joshua-sct/CatAlarm/hardware/catalarm6.kicad_pcb

## KiCad design hardware/catalarm6.kicad_pcb (2025-02-18)

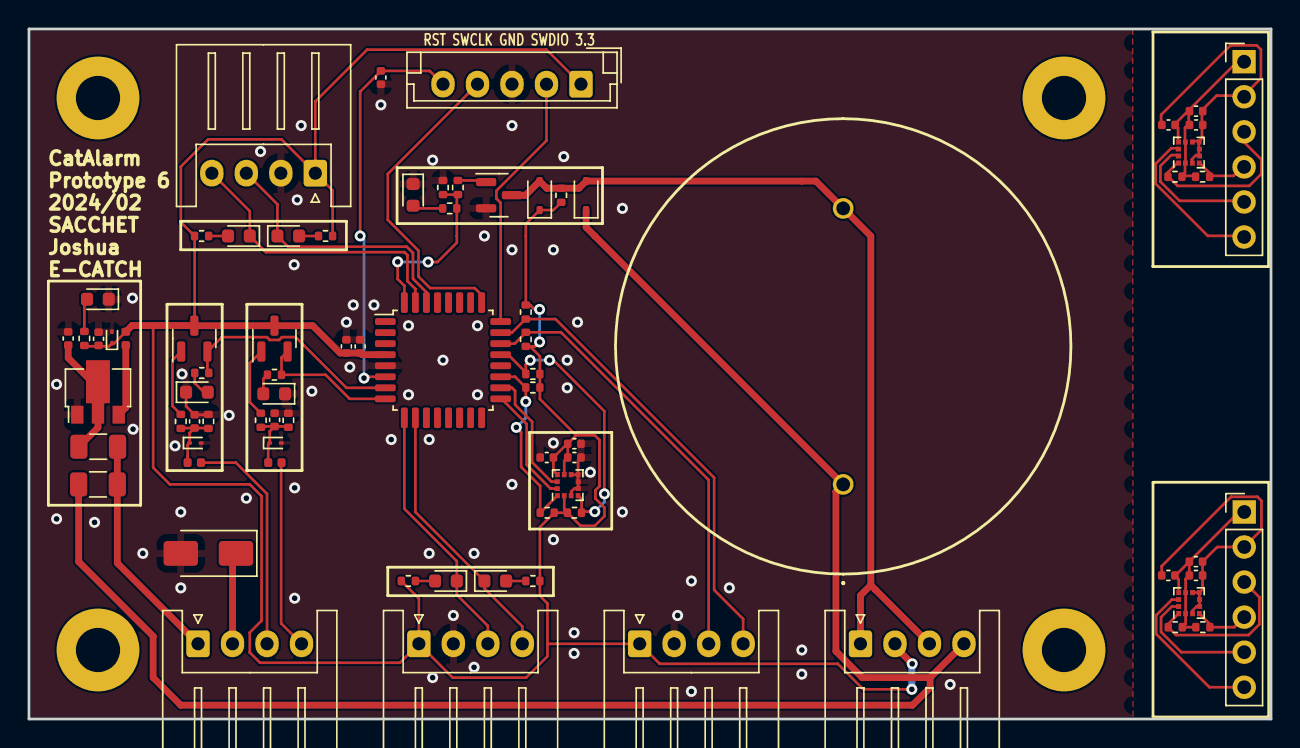
[picture p1: board catalarm6.kicad_pcb from above]

Board: 2 copper layers, 90.0 x 50.0 mm, 81 parts (0 on the bottom side), 51 nets.

Parts:
C1, C2, C6, C8, C10, C11, C12, C14, C15: 100nF; C_0402_1005Metric
C3: 4.7uF; C_0402_1005Metric
C4, C9, C13, C16: 10uF; C_0402_1005Metric
C5, C7: 1nF; C_0402_1005Metric
CON1, CON3, CON4, CON5, CON6: JST_04; JST_XH_S4B-XH-A_1x04_P2.50mm_Horizontal
CON2: JST_05; JST_EH_B5B-EH-A_1x05_P2.50mm_Vertical
D1: SS14; D_SMA
D4, D5, D6: onsemi ESD9B3.3ST5G; D_SOD-923
D_out2, D_out3: D_Schottky; D_SOD-323
F1, F2: JK-nSMD030/16V; Fuse_1206_3216Metric
FB1, FB2, FB3: FerriteBead_Small; L_0402_1005Metric
H1, H2, H3, H4: M3_Hole_With_Spacer_H10mm; MountingHole_3.2mm_With_Spacer_H10mm
J1, J2: PINHD_1x6_Male; PinHeader_1x06_P2.54mm_Vertical
LED1, LED2, LED3, LED4, LED5, LED6, LED7, LED8: LED; LED_0603_1608Metric
LS1: PS-953Q; PS953Q
Q1, Q4, Q6: IRLML6244; SOT-23
R1, R2, R3, R5, R8, R16, R23, R25: 10k; R_0402_1005Metric
R4, R7, R10, R11, R12, R13, R14, R15, R17, R18, R19, R20, R21, R22: 4.7k; R_0402_1005Metric
R6, R9, R24: 10; R_0402_1005Metric
U1: HT7533-3 -1-SOT89; SOT-89-3
U2: STM32G030K8Tx; LQFP-32_7x7mm_P0.8mm
U3, U4, U5: LIS2DW12TR; LGA-12_2x2mm_P0.5mm

Connections:
+3.3V: C3.2, C4.2, C6.2, C8.2, C9.2, C10.2, CON2.1, CON3.2, CON4.1, CON5.1, CON6.1, D6.1 (K), D_out2.1 (K), FB1.2, Q1.3 (D), Q4.3 (D), R1.2, R4.1, R7.2, R10.1, R11.2, R12.1, R13.2, R14.1, R15.1, R17.1, R18.1, R25.1, U2.4 (VDD), U3.2 (~CS), U3.9 (Vdd), U3.10 (Vdd_IO)
/3.3ext: C11.2, C12.2, C13.2, J1.1, R19.1, R20.2, U4.2 (~CS), U4.9 (Vdd), U4.10 (Vdd_IO)
/3.3ext2: C14.2, C15.2, C16.2, J2.1, R21.1, R22.2, U5.2 (~CS), U5.9 (Vdd), U5.10 (Vdd_IO)
/+12V: CON3.4, D_out3.1 (K), F2.2, LS1.1 (+)
/BAT: CON1.1, F1.1, F2.1
/BLK: Q1.2 (S), R2.2, U2.8 (PA1)
/BLK_in: CON1.4, FB3.1
/GNDext: C11.1, C12.1, C13.1, J1.2, U4.3 (SA0/SDO), U4.5 (RES), U4.6 (GND), U4.7 (GND), U4.8 (GND)
/GNDext2: C14.1, C15.1, C16.1, J2.2, U5.3 (SA0/SDO), U5.5 (RES), U5.6 (GND), U5.7 (GND), U5.8 (GND)
/INT1: U2.17 (PB2), U3.12 (INT1)
/INT1ext: J1.5, U4.12 (INT1)
/INT1ext2: J2.5, U5.12 (INT1)
/INT2: U2.18 (PA8), U3.11 (INT2)
/INT2ext: J1.6, U4.11 (INT2)
/INT2ext2: J2.6, U5.11 (INT2)
/RESET: C2.2, CON2.5, U2.6 (NRST)
/SCL: R4.2, R12.2, U2.19 (PA9/NC), U3.1 (SCL/SPC)
/SCL2: CON4.3, R10.2, U2.22 (PA11/PA9)
/SCLext: J1.3, R19.2, U4.1 (SCL/SPC)
/SCLext2: J2.3, R21.2, U5.1 (SCL/SPC)
/SDA: R7.1, R13.1, U2.21 (PA10/NC), U3.4 (SDA/SDI)
/SDA2: CON4.4, R11.1, U2.23 (PA12/PA10)
/SDAext: J1.4, R20.1, U4.4 (SDA/SDI)
/SDAext2: J2.4, R22.1, U5.4 (SDA/SDI)
/SWCLK: CON2.4, U2.25 (PA14)
/SWDIO: CON2.2, U2.24 (PA13)
/USART1_RX: CON6.4, LED8.1 (K), U2.31 (PB7)
/USART1_TX: CON6.3, LED6.1 (K), U2.30 (PB6)
/USART2_RX: CON5.4, LED7.1 (K), U2.10 (PA3)
/USART2_TX: CON5.3, LED5.1 (K), U2.9 (PA2)
/acc: Q4.2 (S), R3.2, U2.7 (PA0)
/acc_in: CON1.3, FB2.1
/out: R16.1, R23.1, R24.1, U2.32 (PB8)
GND: C1.1, C2.1, C3.1, C4.1, C5.1, C6.1, C7.1, C8.1, C9.1, C10.1, CON2.3, CON4.2, CON5.2, CON6.2, D1.2 (A), D4.2 (A), D5.2 (A), D6.2 (A), LED1.1 (K), LED2.1 (K), LED3.1 (K), LED4.1 (K), Q6.2 (S), R5.2, R8.2, R16.2, U1.1 (GND), U2.5 (VSS), U3.3 (SA0/SDO), U3.5 (RES), U3.6 (GND), U3.7 (GND), U3.8 (GND)
unnamed: CON1.2, D1.1 (K)
unnamed: C5.2, D4.1 (K), FB2.2, R8.1, R9.1
unnamed: C7.2, D5.1 (K), FB3.2, R5.1, R6.1
unnamed: CON3.1, CON3.3, D_out2.2 (A), D_out3.2 (A), LS1.2 (-), Q6.3 (D), R25.2
unnamed: LED1.2 (A), R3.1
unnamed: LED2.2 (A), R2.1
unnamed: LED3.2 (A), R23.2
unnamed: LED4.2 (A), R1.1
unnamed: LED5.2 (A), R17.2
unnamed: LED6.2 (A), R14.2
unnamed: LED7.2 (A), R18.2
unnamed: LED8.2 (A), R15.2
unnamed: Q1.1 (G), R6.2
unnamed: Q4.1 (G), R9.2
unnamed: Q6.1 (G), R24.2
unnamed: C1.2, F1.2, U1.2 (VIN)
unnamed: FB1.1, U1.3 (VOUT)
