joshua-sct/CatAlarm/software/CatAlarm.ioc

Mcu.UserName=STM32G030K8Tx
PA0.GPIO_Label=ACC
PA0.Signal=GPXTI0
PA1.GPIO_Label=BLK
PA1.Signal=GPXTI1
PA10.GPIO_Label=AIN_SDA
PA10.Signal=I2C1_SDA
PA13.Signal=SYS_SWDIO
PA14-BOOT0.Signal=SYS_SWCLK
PA2.Signal=USART2_TX
PA3.Signal=USART2_RX
PA8.GPIO_Label=AIN_INT2
PA8.Signal=GPXTI8
PA9.GPIO_Label=AIN_SCL
PA9.Signal=I2C1_SCL
PB2.GPIO_Label=AIN_INT1
PB2.Signal=GPXTI2
PB6.Signal=USART1_TX
PB7.Signal=USART1_RX
PB8.GPIO_Label=BUZZER
PB8.Signal=GPIO_Output
