joshua-sct/CatAlarm/software/Core/Inc/main.h

#define ACC_Pin GPIO_PIN_0
#define ACC_GPIO_Port GPIOA
#define ACC_EXTI_IRQn EXTI0_1_IRQn
#define BLK_Pin GPIO_PIN_1
#define BLK_GPIO_Port GPIOA
#define BLK_EXTI_IRQn EXTI0_1_IRQn
#define AIN_INT1_Pin GPIO_PIN_2
#define AIN_INT1_GPIO_Port GPIOB
#define AIN_INT2_Pin GPIO_PIN_8
#define AIN_INT2_GPIO_Port GPIOA
#define AIN_SCL_Pin GPIO_PIN_9
#define AIN_SCL_GPIO_Port GPIOA
#define AIN_SDA_Pin GPIO_PIN_10
#define AIN_SDA_GPIO_Port GPIOA
#define AOUT_SCL_Pin GPIO_PIN_11
#define AOUT_SCL_GPIO_Port GPIOA
#define AOUT_SDA_Pin GPIO_PIN_12
#define AOUT_SDA_GPIO_Port GPIOA
#define BUZZER_Pin GPIO_PIN_8
#define BUZZER_GPIO_Port GPIOB
