joshua-sct/CatAlarm/(commit log)

2024-03-11 Commencé à fusionner avec les modules cpp du programme arduino
2024-03-11 Commencé à intégré les Log et les "trop sonné" pour la Siren
2024-03-12 Ecriture des méthodes pour la structure Log
2024-03-12 Erreurs de compilations
2024-03-13 Utilisation de timestamp unix partout + Singleton (checkpoint)
2024-03-13 Injection de dépendances pour Log dans Siren
2024-03-13 Erreurs de compilation éliminées
2025-02-18 Project reorganisation
    [catalarm6.csv, catalarm6.kicad_pcb, catalarm6.kicad_sch, catalarm6_bom_.csv]
